CarloRenan/PCB_Avancado_iMX6_Rex/PCB_Avancado/Cotacao/README.md

# Orçamento de fabricação e montagem

Cotação da **JLCPCB** para o módulo iMX6 Rex e a Development Baseboard. Valores em **dólares americanos (USD)**.

## Fabricação das PCBs e montagem

| Item | Quantidade | Prazo de produção | Valor (USD) |
|---|---:|---|---:|
| PCB do módulo iMX6 Rex | 5 | 14–15 dias | US$ 510,03 |
| PCB da Development Baseboard | 5 | 8–9 dias | US$ 43,50 |
| Montagem da placa base nos dois lados | 2 | 5–6 dias | US$ 330,53 |
| **Subtotal, sem frete e tributos** | — | — | **US$ 884,06** |

Os prazos correspondem a cada serviço do orçamento.

## Especificações

| Parâmetro | Módulo | Placa base |
|---|---|---|
| Máscara de solda | Verde | Verde |
| Espessura | 1,6 mm | 1,6 mm |
| Acabamento superficial | ENIG | OSP |
| Quantidade de PCBs | 5 | 5 |
| Montagem PCBA | Indisponível para HDI nesta cotação | 2 unidades, nos dois lados |

O orçamento contempla cinco PCBs de cada modelo e a montagem de duas unidades da placa base. Para o módulo HDI, a JLCPCB informa indisponibilidade do serviço de montagem PCBA.

## Frete

| Serviço | Valor | Prazo estimado | Peso |
|---|---:|---|---|
| DHL Express — módulo | US$ 42,51 | 4–8 dias úteis | 0,15 kg |

O frete do módulo é apresentado separadamente. O subtotal de **US$ 884,06** considera os três itens de fabricação e montagem, sem incluir frete e tributos.

## Registro do orçamento

### Módulo iMX6 Rex

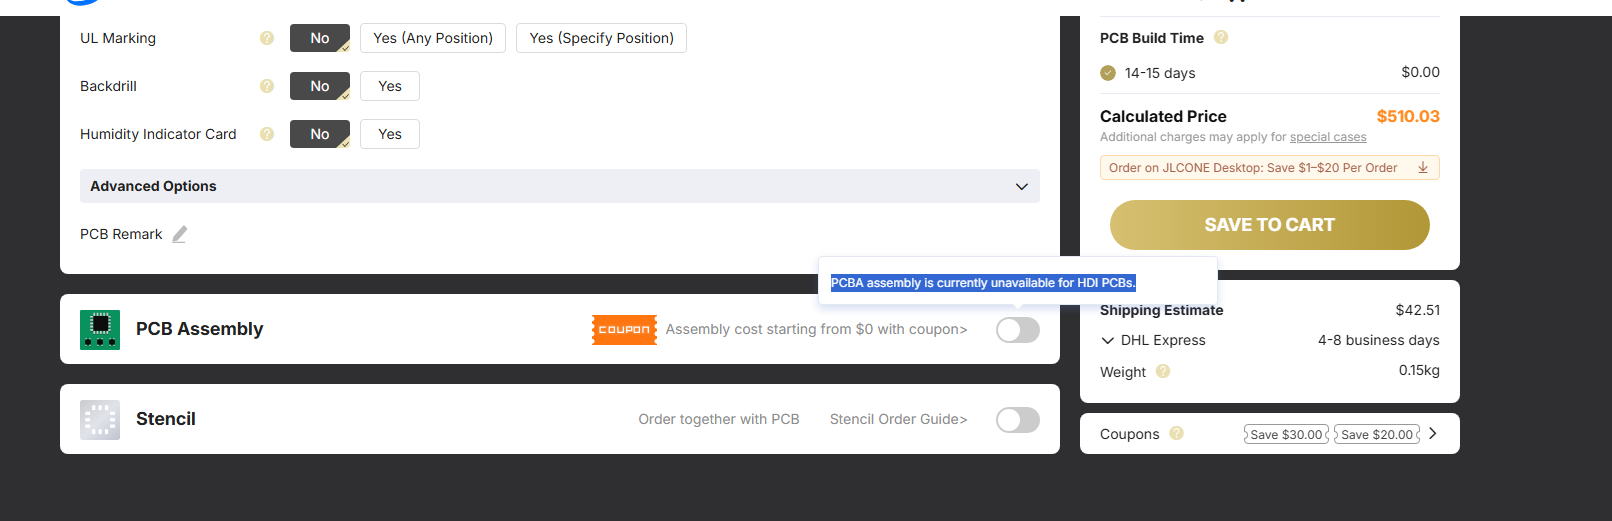
[picture p7: PCB_Avancado/Cotacao/01_Cotacao_modulo_HDI.png]
Cotação do módulo, frete e disponibilidade de montagem HDI


### PCBs e montagem da placa base

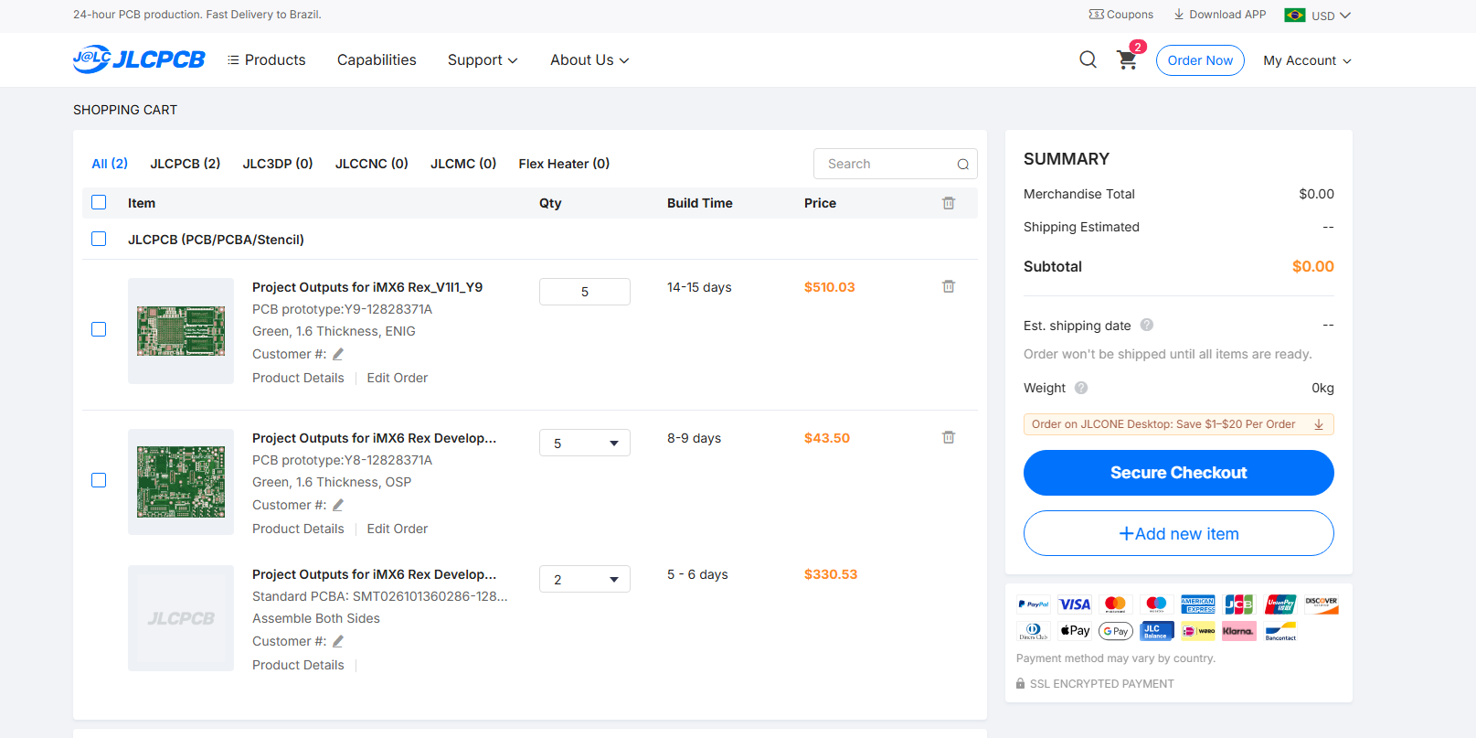
[picture p8: PCB_Avancado/Cotacao/02_Carrinho_PCB_e_montagem.png]
Orçamento das duas PCBs e da montagem da placa base
