CarloRenan/PCB_Avancado_iMX6_Rex/PCB_Avancado/Imagens/README.md

# Layout e vistas 3D

Vistas do módulo **iMX6 Rex — L7-02** e da **Development Baseboard — L7-01**.

## Conjunto

Vista mecânica do conjunto

*Montagem de referência com o modelo STEP M1 do módulo, incorporado ao projeto da placa base.*

## Módulo iMX6 Rex

**70 × 40 mm · 12 camadas de cobre**

| Face superior | Face inferior |
|---|---|
| Módulo — face superior | Módulo — face inferior |

O módulo concentra o processador i.MX6 Quad, a memória DDR3, a flash SPI e o PHY Ethernet. Os conectores J1/J2 fazem a interligação com a placa base.

## Development Baseboard

**135 × 110 mm · 6 camadas de cobre**

| Face superior, sem o módulo | Face inferior |
|---|---|
| Base — face superior | Base — face inferior |

A base distribui a alimentação e oferece os conectores de vídeo, rede, armazenamento, áudio e expansão.

## Layouts 2D

Comparação das quatro faces

| Placa | Face superior | Face inferior |
|---|---|---|
| Módulo | [Layout superior](Modulo_Superior.png) | [Layout inferior](Modulo_Inferior.png) |
| Base | [Layout superior](Placa_base_Superior.png) | [Layout inferior](Placa_base_Inferior.png) |

As vistas 2D apresentam trilhas externas, pads, vias e contornos. As faces inferiores são vistas por baixo. A comparação utiliza escalas diferentes para as duas placas.

## Representação do projeto

As vistas 3D utilizam os modelos STEP, os corpos extrudados e os posicionamentos definidos nos documentos Altium. As representações individuais correspondem à configuração base. Os cartões de expansão CR1/CR2 estão ocultos para facilitar a visualização dos conectores.

A espessura visual é de 1,6 mm. Cores, acabamento, cobre e serigrafia têm representação simplificada.

[Projetos Altium](../Projetos/) · [Funcionamento do circuito](../docs/FUNCIONAMENTO.md)
