CarloRenan/PCB_Avancado_iMX6_Rex/PCB_Avancado/Projetos/Modulo_L7-02/README.md

# Módulo iMX6 Rex

O módulo reúne o processador i.MX6 Quad, a memória DDR3, a flash SPI e os circuitos de alimentação e comunicação. A interligação com a Development Baseboard utiliza os conectores J1/J2.

| Característica | Especificação |
|---|---|
| Etapa do curso | L7-02 — Impedance Adjustment |
| Dimensões | 70 × 40 mm |
| Camadas de cobre | 12 |
| Projeto Altium | `iMX6 Rex_V1I1.PrjPcb` |
| Layout | `iMX6 Rex_V1I1_PCB.PcbDoc` |

Módulo iMX6 Rex em 3D

No Altium Designer, o arquivo `.PrjPcb` reúne os documentos do projeto. O `.PcbDoc` apresenta o posicionamento dos componentes, o roteamento e as camadas da placa.

[Funcionamento](../../docs/FUNCIONAMENTO.md) · [Galeria](../../Imagens/README.md) · [Lista de materiais](../../BoM/README.md)
