CarloRenan/PCB_Avancado_iMX6_Rex/PCB_Avancado/docs/ENTREGA.md

# Apresentação do trabalho

**Aluno:** Carlos Renan  
**Curso:** Advanced PCB Layout Course  
**Projeto:** iMX6 Rex e Development Baseboard  

## Objetivo

Apresentar o estudo de uma plataforma de computação embarcada e das técnicas de layout empregadas em placas multicamadas com interfaces de alta velocidade.

O trabalho relaciona os blocos funcionais dos esquemáticos ao posicionamento e ao roteamento das PCBs, com ênfase no ajuste de impedância do módulo e no ajuste dos pares diferenciais da placa base.

## Escopo

| Placa | Etapa | Características |
|---|---|---|
| Módulo iMX6 Rex | L7-02 — Impedance Adjustment | 70 × 40 mm; 12 camadas de cobre |
| Development Baseboard | L7-01 — Differential Pairs Fine Tuning | 135 × 110 mm; 6 camadas de cobre |

## Documentação do projeto

| Conteúdo | Localização |
|---|---|
| Projetos Altium, esquemáticos e layouts | [Projetos](../Projetos/) |
| Descrição dos componentes e interfaces | [Funcionamento do circuito](FUNCIONAMENTO.md) |
| Vistas 2D e 3D | [Galeria](../Imagens/README.md) |
| Lista de materiais em Excel e CSV | [BOM](../BoM/README.md) |
| Fabricação das PCBs e montagem na JLCPCB | [Orçamento](../Cotacao/README.md) |
| Projeto de referência e bibliografia | [Referências](ORIGEM.md) |

## Tópicos abordados

- Arquitetura do processador, memórias e interfaces.
- Posicionamento de componentes em placas multicamadas.
- Impedância das interligações e planos de referência.
- Roteamento e ajuste de pares diferenciais.
- Distribuição de alimentação e desacoplamento.
- Lista de materiais e orçamento de fabricação e montagem.
