CarloRenan/PCB_Avancado_iMX6_Rex/PCB_Avancado/docs/ORIGEM.md

# Projeto de referência e bibliografia

O estudo utiliza a plataforma **iMX6 Rex** e a **Development Baseboard**, apresentadas no **Advanced PCB Layout Course**, da **FEDEVEL Academy**.

## Etapas do projeto

| Placa | Etapa | Tema |
|---|---|---|
| Módulo iMX6 Rex | L7-02 | Impedance Adjustment |
| Development Baseboard | L7-01 | Differential Pairs Fine Tuning |

Os esquemáticos definem os componentes e as interligações elétricas. Os documentos PCB apresentam o posicionamento, o roteamento e a estrutura de camadas. As listas de materiais relacionam designadores, códigos de fabricante e footprints.

## Referências

- **iMX6 Rex.** Arquitetura e informações da plataforma. [Página do projeto](https://sites.google.com/imx6rex.com/www/home).
- **iMX6 Rex Development Baseboard.** Interfaces e características da placa base. [Documentação da placa](https://sites.google.com/imx6rex.com/www/application/imx6-development-board).
- **Altium Designer.** Variantes de projeto e configuração de montagem. [Documentação de variantes](https://www.altium.com/pt/documentation/altium-designer/design-variants).
- **FEDEVEL Academy.** Advanced PCB Layout Course: L7-02 — Impedance Adjustment e L7-01 — Differential Pairs Fine Tuning.

## Documentos técnicos

[Projetos Altium](../Projetos/) · [Lista de materiais](../BoM/README.md) · [Cotação JLCPCB](../Cotacao/README.md)
