CarloRenan/PCB_Avancado_iMX6_Rex/PCB_Avancado/Imagens/Modulo_Inferior.png

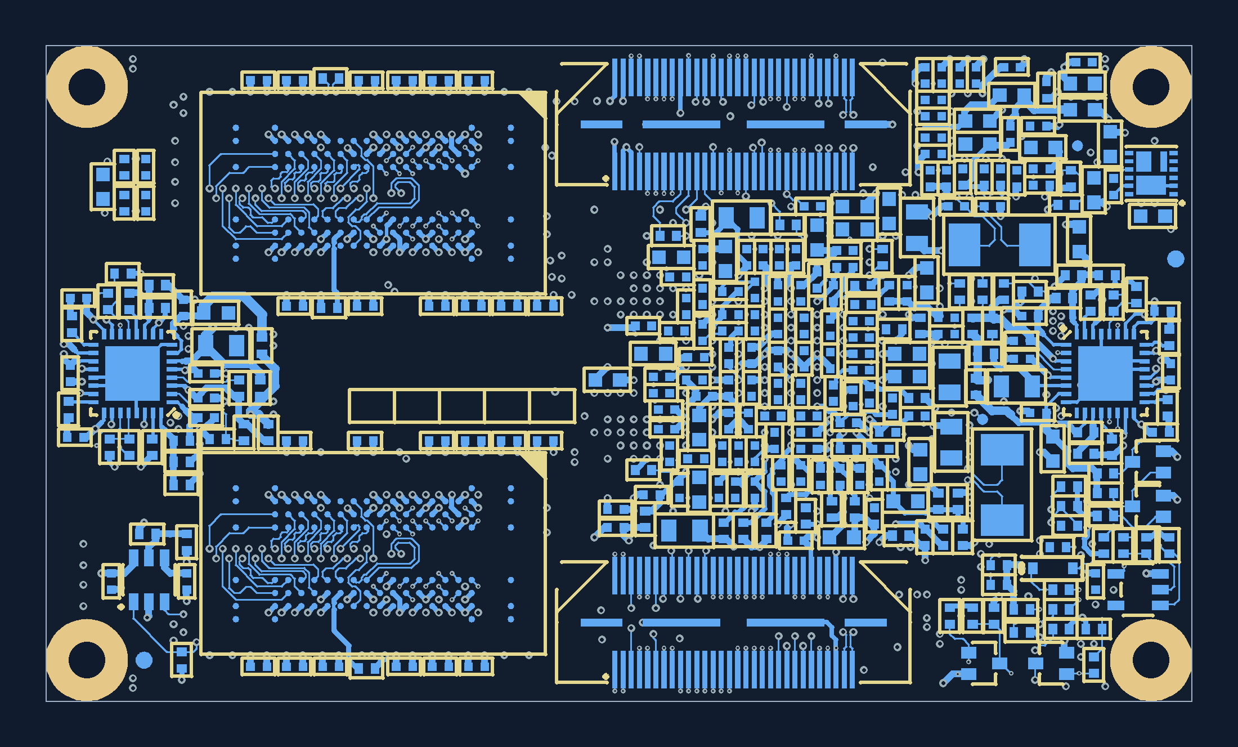
PCB_Avancado/Imagens/Modulo_Inferior.png
