CarloRenan/PCB_Avancado_iMX6_Rex/PCB_Avancado/Imagens/Placa_base_Inferior.png

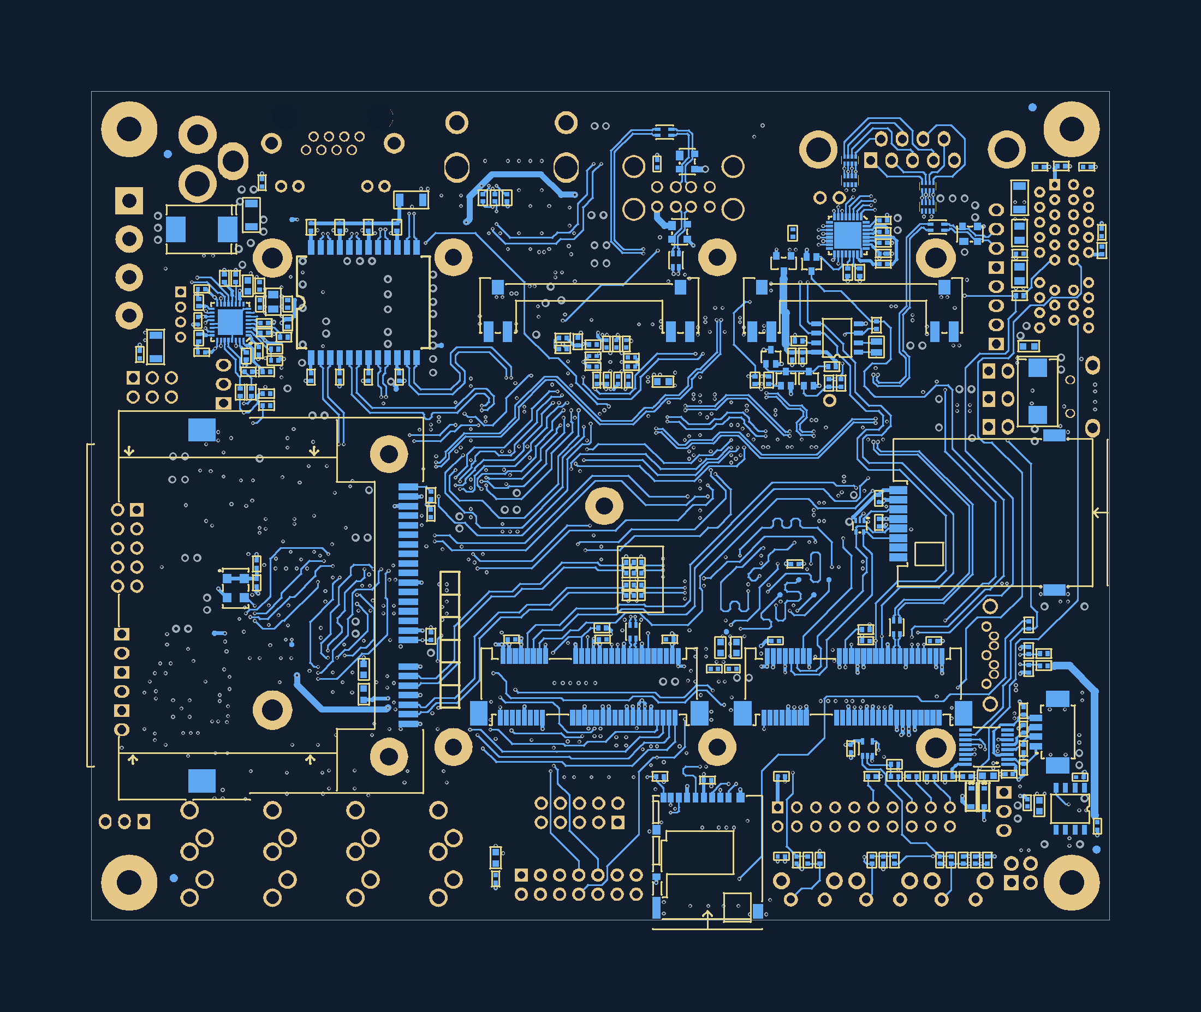
PCB_Avancado/Imagens/Placa_base_Inferior.png
