CarloRenan/PCB_Avancado_iMX6_Rex/PCB_Avancado/Imagens/Placa_base_Superior.png

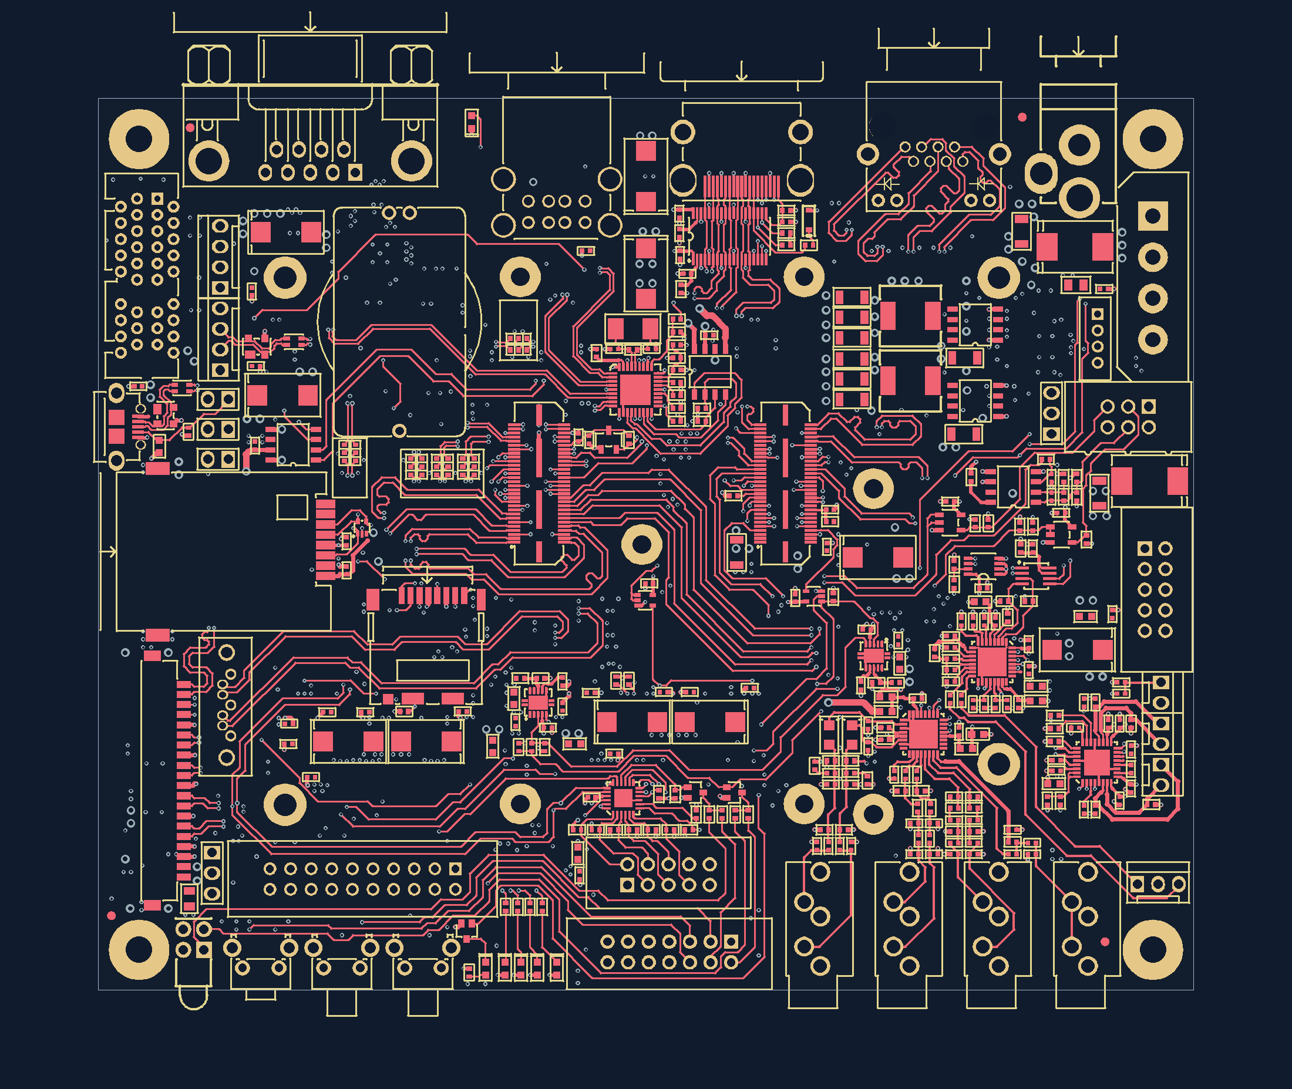
PCB_Avancado/Imagens/Placa_base_Superior.png
