CarloRenan/PCB_Avancado_iMX6_Rex/PCB_Avancado/BoM/BOM_e_Cotacao.xlsx

Sheet: Leia_me
PCB Avançado — Lista de materiais e cotação
Projeto | iMX6 Rex — módulo e Development Baseboard
Escopo da BOM | Projeto base, sem aplicação da variante Prototype; quantidades por uma placa.
Módulo | 457 componentes com MPN, agrupados em 66 linhas; 473 objetos no inventário PCB.
Placa base | 546 componentes com MPN, agrupados em 124 linhas; 580 objetos no inventário PCB.
Fonte | Esquemáticos e arquivos PCB das etapas L7-02 (módulo) e L7-01 (base).
Campos | MPN, fabricante, valor e descrição: esquemático; footprint: PCB.
Variante Prototype | 29 registros de configuração no módulo e 76 na placa base.
Itens auxiliares | Furos, fiduciais, pontos de teste, modelos e itens só do esquemático estão em aba separada.
Configuração | BOM da configuração base. A variante Prototype possui registros próprios nos arquivos CSV.
Cotação | Orçamento JLCPCB em dólares americanos (USD), com fabricação e montagem da placa base.
Arquivos de apoio | BOMs em CSV na pasta BoM e orçamento detalhado na pasta Cotacao.

Sheet: BOM_Modulo
BOM | Módulo
Projeto base • sem aplicar Prototype • quantidades por uma placa
Fonte: Modulo_L7-02 / arquivos SchDoc + PcbDoc
Designators | Qtd. / placa | Valor / comentário | Código do fabricante (MPN) | Fabricante | Footprint | Descrição
C1, C206, C207, C225, C226 | 5 | 1uF | C1005X5R1C105K | TDK Corporation | C0402 | CAP CER 1UF 16V 10% X5R 0402
C2, C209, C210, C220, C228, C229, C241 | 7 | 10uF | GRM31CR6YA106KA12L | Murata Electronics North America | C1206 | CAP CER 10UF 35V 10% X5R 1206
C3, C4, C5, C6, C8, C9, C10, C11, C21, C22, C23, C24, C25, C26, C27, C28, C29, C30, C31, C32, C33, C34, C35, C36, C37, C38, C39, C40, C41, C42, C43, C44, C45, C46, C47, C48, C49, C50, C51, C52, C53, C54, C55, C56, C57, C58, C59, C60, C61, C62, C64, C68, C73, C75, C76, C77, C79, C81, C82, C90, C91, C92, C93, C94, C95, C97, C98, C99, C100, C102, C103, C104, C105, C107, C108, C109, C110, C112, C113, C114, C115, C116, C117, C119, C120, C121, C122, C123, C124, C125, C126, C130, C131, C132, C133, C134, C136, C138, C140, C142, C143, C144, C145, C146, C149, C150, C152, C153, C154, C155, C157, C158, C159, C160, C161, C162, C163, C164, C165, C166, C167, C168, C169, C170, C171, C174 | 126 | 220nF | C1005X5R1E224M | TDK Corporation | C0402 | CAP CER 0.22UF 25V 20% X5R 0402
C7, C18, C20, C63, C65, C66, C67, C74, C87, C88, C89, C181, C187, C190, C192, C195, C203, C205, C211, C212, C219, C224, C230, C231, C238, C239, C240, C242 | 28 | 100nF | C1005X5R1H104K | TDK Corporation | C0402 | CAP CER 0.1UF 50V 10% X5R 0402
C12, C13, C14, C15, C16, C17, C96, C101, C106, C111, C118, C127, C128, C129, C135, C151, C172, C173 | 18 | 22u | GRM188R60G226MEA0L | Murata Electronics North America | C0603 | CAP CER 22UF 4V 20% X5R 0603
C19, C80, C177, C178, C180, C186, C191, C194, C199, C204, C221, C222, C223 | 13 | 10µF | C1608X5R0J106M | TDK Corporation | C0603 | CAP CER 10UF 6.3V 20% X5R 0603
C69, C70, C71, C72, C139 | 5 | 10nF | C1005X7R1H103K | TDK Corporation | C0402 | CAP CER 10000PF 50V 10% X7R 0402
C78, C243, C244, C245, C246, C247 | 6 | 4u7 | C1005X5R1A475M | TDK Corporation | C0402 | CAP CER 4.7UF 10V 20% X5R 0402
C83, C84, C85, C86 | 4 | 18pF | C1005C0G1H180J | TDK Corporation | C0402 | CAP CER 18PF 50V 5% NP0 0402
C137, C141, C147, C148, C156 | 5 | 22u | C2012X5R1C226K | TDK Corporation | C0805 | CAP CER 22UF 16V 10% X5R 0805
C175, C176 | 2 | 22pF | C1005C0G1H220J | TDK Corporation | C0402 | CAP CER 22PF 50V 5% NP0 0402
C179 | 1 | 560pF | GRM1555C1H561JA01D | Murata Electronics North America | C0402 | CAP CER 560PF 50V 5% NP0 0402
C182, C183, C184, C185, C188, C189, C193, C196, C197, C198, C200, C201, C202, C218, C237, C248, C249 | 17 | 10nF | C1005X7R1C103K | TDK Corporation | C0402 | CAP CER 10000PF 16V 10% X7R 0402
C208, C227 | 2 | 1uF | GRM21BR71H105KA12L | Murata Electronics North America | C0805 | CAP CER 1UF 50V 10% X7R 0805
C213, C214, C215, C216, C217, C232, C233, C234, C235, C236 | 10 | 100µF | C3216X5R1A107M | TDK Corporation | C1206 | CAP CER 100UF 10V 20% X5R 1206
D1 | 1 | RB751V-40-TP | RB751V-40-TP | Micro Commercial Co | SOD323 | DIODE SCHTKY 30MA 30V SOD-323
D2 | 1 | Green | LG L29K-G2J1-24-Z | OSRAM Opto Semiconductors Inc | LED_0603 | LED SMARTLED GREEN 570NM 0603
D3 | 1 | Orange | LO L29K-H2K1-24-Z | OSRAM Opto Semiconductors Inc | LED_0603 | LED SMARTLED ORANGE 606NM 0603
FB1, FB2, FB8 | 3 | 220R, 2.5A | BLM18SG221TN1D | Murata Electronics North America | C0603 | FERRITE CHIP 220 OHM 2500MA 0603
FB3, FB4, FB6, FB7 | 4 | BLM18KG101TN1D | BLM18KG101TN1D | Murata Electronics North America | C0603 | FERRITE CHIP 100 OHM BEAD 0603
FB5 | 1 | BLM15AX601SN1D | BLM15AX601SN1D | Murata Electronics North America | C0402 | FERRITE CHIP 600 OHM 0402
J1, J2 | 2 | QSH-030-01-L-D-A | QSH-030-01-L-D-A | Samtec Inc | QSH-030-01-L-D-A | CONN RCPT HI-SPD .5MM 60POS DL
L1 | 1 | 4µ7 | IHLP2525CZER4R7M01 | Vishay/Dale | IHLP_255MILX270MIL | INDUCTOR POWER 4.7UH 5.5A SMD
L2, L4, L5 | 3 | 3u3 | IHLP2525CZER3R3M01 | Vishay Dale | IHLP_255MILX270MIL | INDUCTOR POWER 3.3UH 6A SMD
L3 | 1 | VLCF4020T-100MR85 | VLCF4020T-100MR85 | TDK Corporation | VLCF4020 | INDUCTOR POWER 10UH .85A SMD
Q1, Q2, Q5, Q8, Q9 | 5 | 2N7002BKW,115 | 2N7002BKW,115 | NXP Semiconductors | SC70_SOT323 | MOSFET N-CH 60V 310MA SOT323
Q3, Q4, Q6, Q7 | 4 | SI4816BDY-T1-GE3 | SI4816BDY-T1-GE3 | Vishay/Siliconix | 8_SOIC_3.9MM | MOSFET DL N-CH 30V 6.8A 8-SOIC
R1, R35, R36, R50, R52, R66, R72, R83, R85, R86, R90, R92, R112, R159, R160, R161 | 16 | 22R | RC0402FR-0722RL | Yageo | R0402 | RES 22.0 OHM 1/16W 1% 0402 SMD
R2, R3, R15 | 3 | 200R | CRCW0402200RFKED | Vishay Dale | R0402 | RES 200 OHM 1/16W 1% 0402 SMD
R4, R5, R8, R9, R10, R11, R12 | 7 | 240R | RMCF0402FT240R | Stackpole Electronics Inc | R0402 | RES TF 240 OHM 1% 0.0625W 0402
R6, R7, R33, R38, R39, R40, R41, R42, R43, R48, R49, R57, R58, R60, R62, R63, R64, R67, R68, R69, R75, R91, R94, R95, R96, R97, R98, R100, R103, R104, R109, R110, R115, R127, R129, R130, R131, R132, R133, R136, R151, R153, R154, R155, R158, R165 | 46 | 10k | RC0402FR-0710KL | Yageo | R0402 | RES 10.0K OHM 1/16W 1% 0402 SMD
R13, R14, R18, R19, R23, R24, R25, R26, R27, R34, R51, R65, R70, R71, R74, R76, R78, R80, R88, R93, R105, R106, R107, R108, R116, R117, R128, R140, R141, R152, R156, R157, R163, R164 | 34 | 0R | RC0402JR-070RL | Yageo | R0402 | RES 0.0 OHM 1/16W 0402 SMD
R16, R17 | 2 | 49.9R | RC0402FR-0749R9L | Yageo | R0402 | RES 49.9 OHM 1/16W 1% 0402 SMD
R20 | 1 | 191R | CRCW0402191RFKED | Vishay Dale | R0402 | RES 191 OHM 1/16W 1% 0402 SMD
R21, R22 | 2 | 47k | RC0402FR-0747KL | Yageo | R0402 | RES 47.0K OHM 1/16W 1% 0402 SMD
R28, R29, R31, R32, R44, R45, R46, R47, R55, R56, R59, R84, R87, R89, R120 | 15 | 4k99 | RMCF0402FT4K99 | Stackpole Electronics Inc | R0402 | RES TF 4.99K OHM 1% 1/16W 0402
R30 | 1 | 1k6 | ERJ-2RKF1601X | Panasonic Electronic Components | R0402 | RES 1.6K OHM 1/10W 1% 0402 SMD
R37 | 1 | 2M2 | CRCW04022M20FKED | Vishay Dale | R0402 | RES 2.20M OHM 1/16W 1% 0402 SMD
R53, R54 | 2 | 10M | CRCW040210M0FKED | Vishay Dale | R0402 | RES 10.0M OHM 1/16W 1% 0402 SMD
R61, R99, R101, R102, R162 | 5 | 1k | RC0402FR-071KL | Yageo | R0402 | RES 1.00K OHM 1/16W 1% 0402 SMD
R73, R111, R137, R143, R144 | 5 | 100k | RMCF0402FT100K | Stackpole Electronics Inc | R0402 | RES 100K OHM 1/16W 1% 0402 SMD
R77 | 1 | 2R2 | CRCW04022R20FKED | Vishay Dale | R0402 | RES 2.20 OHM 1/16W 1% 0402 SMD
R79, R118, R142 | 3 | 10R | RC0402FR-0710RL | Yageo | R0402 | RES 10.0 OHM 1/16W 1% 0402 SMD
R81, R82, R113, R114 | 4 | 220R | RC0402FR-07220RL | Yageo | R0402 | RES 220 OHM 1/16W 1% 0402 SMD
R119 | 1 | 14K | RC0402FR-0714KL | Yageo | R0402 | RES 14.0K OHM 1/16W 1% 0402 SMD
R121, R122, R145, R146 | 4 | 1R | RC0402FR-071RL | Yageo | R0402 | RES 1.00 OHM 1/16W 1% 0402 SMD
R123 | 1 | 39k | RC0402FR-0739KL | Yageo | R0402 | RES 39.0K OHM 1/16W 1% 0402 SMD
R124, R125, R148, R149 | 4 | 200k | RC0402FR-07200KL | Yageo | R0402 | RES 200K OHM 1/16W 1% 0402 SMD
R126, R150 | 2 | 10k5 | CRCW040210K5FKED | Vishay/Dale | R0402 | RES 10.5K OHM 1/16W 1% 0402 SMD
R134 | 1 | 12k | RC0402FR-0712KL | Yageo | R0402 | RES 12.0K OHM 1/16W 1% 0402 SMD
R135 | 1 | 3k3 | RC0402FR-073K3L | Yageo | R0402 | RES 3.30K OHM 1/16W 1% 0402 SMD
R138 | 1 | 330k | CRCW0402330KFKED | Vishay Dale | R0402 | RES 330K OHM 1/16W 1% 0402 SMD
R139 | 1 | 120k | RC0402FR-07120KL | Yageo | R0402 | RES 120K OHM 1/16W 1% 0402 SMD
R147 | 1 | 27k | RC0402FR-0727KL | Yageo | R0402 | RES 27.0K OHM 1/16W 1% 0402 SMD
U1 | 1 | MCIMX6Q5EYM10AC | MCIMX6Q5EYM10AC | Freescale Semiconductor | PBGA624 | IC MCU 32BIT ARM QUAD 624FCBGA
U2, U3, U4, U5 | 4 | MT41J128M16HA-15E:D TR | MT41J128M16HA-15E:D TR | Micron Technology Inc | 96_FPGA_DD3 | IC DDR3 SDRAM 2GBIT 667MHZ 96BGA
U6 | 1 | TPS3808G09DBVR | TPS3808G09DBVR | Texas Instruments | DBV_SOT_23_6 | IC VOLT SUPERVISOR 0.9V SOT23-6
U7 | 1 | SN74AHC1G09DBVR | SN74AHC1G09DBVR | Texas Instruments | DBV_SOT_23_5 | IC GATE AND SGL 2INP SOT23-5
U8 | 1 | KSZ9021RN | KSZ9021RN | Micrel Inc | QFN48_7MMX7MM | IC TXRX 10/100/1000 SGL 48QFN
U9 | 1 | MIC33050-4YHL TR | MIC33050-4YHL TR | Micrel Inc | MLF_3X3_12PINS | IC BUCK SYNC 1.2V 0.6A 12MLF
U10 | 1 | SST25VF016B-75-4I-QAF-ND | SST25VF016B-75-4I-QAF | Microchip Technology | WSON8_6X5MM | IC FLASH 16MBIT 75MHZ 8WSON
U11, U13 | 2 | ISL6236AIRZ | ISL6236AIRZ | Intersil | 32_VFQFN_EXPOSED_PAD | IC MAIN PWR CTRLR QUAD 32-QFN
U12 | 1 | TPS62175DQCT | TPS62175DQCT | Texas Instruments | DQC_PWSON-N10 | IC REG BUCK SYNC ADJ 0.5A 10WSON
Y1 | 1 | 24MHz | ABM7-24.000MHZ-D-2-Y-T | Abracon Corporation | ABM7_V1_1 | CRYSTAL 24.0000MHZ 18PF SMD
Y2 | 1 | 32.768kHz | ABS06-32.768KHZ-9-1-T | Abracon Corporation | ABS06 | CRYSTAL 32.768 KHZ 9.0 PF SMD
Y3 | 1 | 25MHz | ABM7-25.000MHZ-D-2-Y-T | Abracon Corporation | ABM7_V1_1 | CRYSTAL 25.0000 MHZ 18PF SMD
Total de componentes com MPN | 457

Sheet: BOM_Base
BOM | Placa base
Projeto base • sem aplicar Prototype • quantidades por uma placa
Fonte: Placa_base_L7-01 / arquivos SchDoc + PcbDoc
Designators | Qtd. / placa | Valor / comentário | Código do fabricante (MPN) | Fabricante | Footprint | Descrição
C1, C3, C6, C8, C9, C10, C14, C17, C22, C23, C27, C28, C29, C30, C31, C57, C69, C71, C72, C73, C74, C75, C77, C78, C80, C83, C84, C86, C88, C89, C90, C93, C94, C97, C98, C101, C103, C106, C108, C109, C110, C111, C112, C114, C115, C116, C117, C118, C120, C121, C127, C128, C129, C140, C148, C151, C152, C153, C154, C155, C156, C157, C158, C163, C166, C167, C170, C171, C173, C175, C176, C178, C180, C186, C187, C195, C198, C199, C200, C201, C202, C203, C204, C205, C206, C207, C213, C214, C216, C218 | 90 | 100nF | C1005X5R1H104K | TDK Corporation | C0402 | CAP CER 0.1UF 50V 10% X5R 0402
C2, C7, C82, C184, C185, C196, C197, C208 | 8 | 10uF | GRM31CR6YA106KA12L | Murata Electronics North America | C1206 | CAP CER 10UF 35V 10% X5R 1206
C4, C18, C33, C37, C38, C39, C41, C42, C44, C45, C46, C48, C50, C51, C53, C58, C59, C60, C61, C63, C64, C65, C66, C68, C81, C95, C105, C107, C113, C130, C131, C136, C138, C147, C159, C161, C162, C168, C169, C181, C182, C209, C211 | 43 | 1uF | C1005X5R1C105K | TDK Corporation | C0402 | CAP CER 1UF 16V 10% X5R 0402
C5, C11, C79, C177 | 4 | 22u | C2012X5R1C226K | TDK Corporation | C0805 | CAP CER 22UF 16V 10% X5R 0805
C12, C13, C24, C25, C70 | 5 | 330u | T520D337M006ATE045 | Kemet | C2917 | CAP TANT 330UF 6.3V 20% 2917
C15, C16, C19, C26, C32, C34, C102, C104, C141, C142, C210, C212, C215, C217 | 14 | 4u7 | C1005X5R1A475M | TDK Corporation | C0402 | CAP CER 4.7UF 10V 20% X5R 0402
C20, C35, C43, C76, C126, C150, C172, C174, C179 | 9 | 10µF | C1608X5R0J106M | TDK Corporation | C0603 | CAP CER 10UF 6.3V 20% X5R 0603
C21, C36, C132, C133, C143, C144 | 6 | 2700pF | GRM155R71H272KA01D | Murata Electronics North America | C0402 | CAP CER 2700PF 50V 10% X7R 0402
C40, C85, C87, C91, C92, C96 | 6 | 330u | T495D337K010ATE150 | Kemet | C2917 | CAP TANT 330UF 10V 10% 2917
C47, C52, C55, C56, C67 | 5 | 470nF | C1005X5R1C474K | TDK Corporation | C0402 | CAP CER 0.47UF 16V 10% X5R 0402
C49 | 1 | 10nF | C1005X7R1H103K | TDK Corporation | C0402 | CAP CER 10000PF 50V 10% X7R 0402
C54, C122, C123, C134, C135, C145, C146, C149 | 8 | 270pF | GRM155R71H271KA01D | Murata Electronics North America | C0402 | CAP CER 270PF 50V 10% X7R 0402
C62 | 1 | 2u2 | C1005X5R1A225K | TDK Corporation | C0402 | CAP CER 2.2UF 10V 10% X5R 0402
C99, C100 | 2 | 18pF | C1005C0G1H180J | TDK Corporation | C0402 | CAP CER 18PF 50V 5% NP0 0402
C119 | 1 | 1000pF, 2kV | C1206X102KGRACTU | Kemet | C1206 | CAP CER 1000PF 2KV 10% X7R 1206
C124, C125 | 2 | 100pF | C1005C0G1H101J | TDK Corporation | C0402 | CAP CER 100PF 50V 5% NP0 0402
C137, C139 | 2 | 220u, 4V | TLNS227M004R3000 | AVX Corporation | C1206 - TLN S Case Tantal | CAP TANT 220UF 4V 20% 1206
C160 | 1 | 220nF | C1005X5R1E224M | TDK Corporation | C0402 | CAP CER 0.22UF 25V 20% X5R 0402
C164, C165 | 2 | 4x 220pF | CKCL44X7R1H221M | TDK Corporation | 4X_CAP_CC0805_CKCL44 | CAP ARRAY 4CH 220PF 50V 0805
C183 | 1 | 1uF | GRM21BR71H105KA12L | Murata Electronics North America | C0805 | CAP CER 1UF 50V 10% X7R 0805
C188, C189, C190, C191, C192, C193 | 6 | 100µF | C3216X5R1A107M | TDK Corporation | C1206 | CAP CER 100UF 10V 20% X5R 1206
C194 | 1 | 10nF | C1005X7R1C103K | TDK Corporation | C0402 | CAP CER 10000PF 16V 10% X7R 0402
CFAST1 | 1 | 7E50-C016-00 | 7E50-C016-00 | 3M | CFAST_LOCKER | CF CARD EJECT/LATCHING RETAINER
D1, D2, D3, D6 | 4 | Green | LG L29K-G2J1-24-Z | OSRAM Opto Semiconductors Inc | LED_0603 | LED SMARTLED GREEN 570NM 0603
D4, D5 | 2 | BZA956A,115 | BZA956A,115 | NXP Semiconductors | SOT665 | TVS ZENER QUAD 5.6V SOT665
D7, D21, D22 | 3 | BAT54HT1G | BAT54HT1G | Fairchild Semiconductor | SOD323 | DIODE SCHOTTKY 30V 0.2A SOD323
D8, D9, D10, D11, D13 | 5 | BGX50AE6327 | BGX50AE6327 | Infineon Technologies | SOT143 | DIODE SWITCHING 50V SOT-143
D12, D14 | 2 | Red | LS L29K-H1J2-1-Z | OSRAM Opto Semiconductors Inc | LED_0603 | LED SMARTLED RED 630NM 0603 SMD
D15 | 1 | BAT54C-7-F | BAT54C-7-F | Diodes Inc | SOT-23-3-123 | DIODE SCHOTTKY DUAL 30V SOT23-3
D16, D17, D20 | 3 | B560C-13-F | B560C-13-F | Diodes Inc | SMC | DIODE SCHOTTKY 60V 5A SMC
D18 | 1 | 553-0121F | 553-0121F | Dialight | 553-0121F | LED 2HI 3MM GREEN OVER RED PCMNT
D19 | 1 | PGB1010603MR | PGB1010603MR | Littelfuse Inc | C0603 | SUPPRESSOR ESD 24VDC 0603 SMD
FB1, FB2, FB3, FB4, FB22 | 5 | 220R, 2.5A | BLM18SG221TN1D | Murata Electronics North America | C0603 | FERRITE CHIP 220 OHM 2500MA 0603
FB5, FB8, FB9, FB14, FB15, FB16, FB17, FB18, FB24 | 9 | BLM15AX601SN1D | BLM15AX601SN1D | Murata Electronics North America | C0402 | FERRITE CHIP 600 OHM 0402
FB6, FB7, FB10, FB11, FB12, FB13, FB19, FB23, FB25, FB26 | 10 | MPZ1608S601A 600OHM/1A | MPZ1608S601A | TDK Corporation | C0603 | FERRITE CHIP BEAD 600 OHM SMD
FB20, FB21 | 2 | 4x 220R | BLA2ABB221SN4D | Murata Electronics North America | 4X0402_BLA2A_MURATA | FERRITE ARRAY 220 OHM 0804 SMD
J1, J2 | 2 | QTH-030-01-L-D-A | QTH-030-01-L-D-A | Samtec Inc | QTH-030-01-L-D-A | CONN HEADER HS .5MM 60POS DL AU
J3 | 1 | 10018783-10010TLF | 10018783-10010TLF | FCI | MINI_PCIE_36PIN | CONN PCI EXPRESS 36POS VERT PCB
J4, J9 | 2 | MM60-52B1-E1-R650 | MM60-52B1-E1-R650 | JAE Electronics | MINI_PCIE_52PIN_CARD_CON | CONN MINI EXPRESS CARD 52POS SMD
J5, J7 | 2 | 0475531001 | 0475531001 | Molex Inc | SIM_CARD_PUSH | CONN CARD HOLDER SIM 6POS SMD
J6, J8 | 2 | MM60-EZH059-B5-R650 | MM60-EZH059-B5-R650 | JAE Electronics | MINI_PCIE_52PIN_CARD_LATCH | CONN MINI EXPRESS CARD LATCH SMD
J10, J11, J12 | 3 | 76384-302LF | 76384-302LF | FCI | HDR_1X2_2.54MM_SHDR | CONN HEADER 2POS .100" STR GOLD
J13 | 1 | 76384-303LF | 76384-303LF | FCI | HDR_1X3_2.54MM_SHDR_V2 | CONN HEADER 3POS .100" STR GOLD
J14 | 1 | 0471554001 | 0471554001 | Molex Inc | SATA_VERTICAL | CONN SATA HDR 7POS PCB VERT
J15 | 1 | N7G24-A0B2RB-10-0HT | N7G24-A0B2RB-10-0HT | 3M | CFAST10 | CFAST HEADER STANDOFF SMD R/A
J16 | 1 | 47151-0001 | 47151-0001 | Molex Connector Corporation | HDMI | CONN RCPT 19POS HDMI RT ANG SMD
J17, J18 | 2 | HDR 1x3 | 68000-103HLF | FCI | HDR_1X3_2.54MM | BERGSTIK II .100" SR STRAIGHT
J19 | 1 | HDR 2X3, BOXED | 30306-6002HB | 3M | HDR_2X3_2.54MM_BOXED | CONN HEADER 6POS DL STR GOLD
J20, J23 | 2 | 76384-304LF | 76384-304LF | FCI | HDR_1X4_2.54MM_SHDR | CONN HEADER 4POS .100" STR GOLD
J21 | 1 | USB MICRO AB | 0475890001 | Molex Inc | USB_MICRO_AB | CONN RCPT MICRO USB AB R/A SMD
J22 | 1 | 5787617-1 | 5787617-1 | TE Connectivity | USB-2A | CONN RCPT R/A 4OVER4POS GOLD PCB
J24 | 1 | 2-406549-1 | 2-406549-1 | Tyco | RJ45LED | CONN MOD JACK 8POS R/A Y-G PCB
J25 | 1 | SJ1-3535NG | SJ1-3535NG | CUI Inc | SJ1-3535NG | CONN JACK STEREO R/A 5PIN 3.5MM
J26 | 1 | SJ1-3535NG-BE | SJ1-3535NG-BE | CUI Inc | SJ1-3535NG | CONN JACK STEREO 5POS 3.5MM PCB
J27 | 1 | SJ1-3535NG-GR | SJ1-3535NG-GR | CUI Inc | SJ1-3535NG | CONN JACK STEREO 5POS 3.5MM PCB
J28 | 1 | SJ1-3535NG-PI | SJ1-3535NG-PI | CUI Inc | SJ1-3535NG | CONN JACK STEREO 5POS 3.5MM PCB
J29 | 1 | DM3AT-SF-PEJM5 | DM3AT-SF-PEJM5 | Hirose Electric Co Ltd | USD_DM3AT | CONN MICRO SD R/A PUSH-PUSH SMD
J30 | 1 | 1734351-1 | 1734351-1 | TE Connectivity | DBA9_M_RA | CONN D-SUB PLUG R/A 9POS GOLD/FL
J31, J34 | 2 | HDR 2x5, BOXED | D2510-6002-AR | 3M | HDR_2X5_2.54MM_BOXED | CONN HEADER 10POS VERT 10GOLD
J32 | 1 | BA2032 | BA2032 | MPD (Memory Protection Devices) | BA2032 | HOLDER COIN CELL CR2032 EJECT
J33 | 1 | HDR 2x7, BOXED | D2514-6002-AR | 3M | HDR_2X7_2.54MM_BOXED | CONN HEADER 14POS VERT 10GOLD
J35 | 1 | Hdr 4x2mm BOXED | 0532530470 | Molex Inc | HDR_1X4_2MM_SHDR | CONN HEADER 4POS 2MM VERT TIN
J36 | 1 | 5103308-5 | 5103308-5 | TE Connectivity | HDR_2x10_2.54mm_BOXED | CONN HEADER LOPRO STR 20POS GOLD
J37 | 1 | PJ-002AH | PJ-002AH | CUI Inc | POWER_JACK_5.5_2.1MM_NS | CONN PWR JACK 2.1X5.5MM HIGH CUR
J38 | 1 | 0015244449 | 0015244449 | Molex Inc | 015244449 | CONN HEADER 4POS .200 VERT
J39 | 1 | DM3C-SF | DM3C-SF | Hirose Electric Co Ltd | USD_DM3CS | CONN MICRO SD R/A HING TYPE SMD
J40 | 1 | 0532610471 | 0532610471 | Molex Inc | 0532610471 | CONN HEADER 4POS 1.25MM R/A SMD
J41 | 1 | FI-SE20P-HFE | FI-SE20P-HFE | JAE Electronics | FI-SE20P-HFE | CONN RCPT 1.25MM 20POS SMD R/A
JP1, JP2, JP3 | 3 | HDR 1x2 | 68001-202HLF | FCI | HDR_1X2_2.54MM | BERGSTIK II .100" SR STRAIGHT
L1, L2, L3, L4, L5, L6, L7 | 7 | ACM2012-900-2P-T002 | ACM2012-900-2P-T002 | TDK Corporation | ACM2012 | CHOKE COMM MODE 90 OHM .4A SMD
L8, L9 | 2 | 4µ7 | IHLP2525CZER4R7M01 | Vishay/Dale | IHLP_255MILX270MIL | INDUCTOR POWER 4.7UH 5.5A SMD
Q1, Q4, Q5, Q6, Q7, Q8, Q9 | 7 | 2N7002BKW,115 | 2N7002BKW,115 | NXP Semiconductors | SC70_SOT323 | MOSFET N-CH 60V 310MA SOT323
Q2, Q3 | 2 | SI4816BDY-T1-GE3 | SI4816BDY-T1-GE3 | Vishay/Siliconix | 8_SOIC_3.9MM | MOSFET DL N-CH 30V 6.8A 8-SOIC
R1, R2, R3, R4, R5, R6, R7, R8, R9, R10, R11, R12, R13, R14, R16, R24, R32, R34, R36, R37, R38, R39, R40, R41, R42, R43, R46, R56, R62, R63, R64, R65, R66, R67, R68, R69, R88, R89, R104, R105, R106, R112, R113, R120, R123, R124, R128, R129, R130, R133, R137, R138, R143, R153, R155, R156, R159, R162, R163, R164, R169, R170, R173, R174, R184 | 65 | 0R | RC0402JR-070RL | Yageo | R0402 | RES 0.0 OHM 1/16W 0402 SMD
R15, R31, R33, R35, R51, R52, R53, R54, R55, R70, R71, R72, R73, R108, R109, R111, R114, R115, R116, R117, R118, R121, R122, R134, R135, R136, R139, R140, R147, R150, R151, R152, R154, R157, R158, R165, R166, R167, R168, R172, R183, R187 | 42 | 10k | RC0402FR-0710KL | Yageo | R0402 | RES 10.0K OHM 1/16W 1% 0402 SMD
R17, R131, R132, R175, R176, R177, R178, R179, R180, R181, R182 | 11 | 200k | RC0402FR-07200KL | Yageo | R0402 | RES 200K OHM 1/16W 1% 0402 SMD
R18 | 1 | 2k1 | CRCW04022K10FKED | Vishay Dale | R0402 | RES 2.10K OHM 1/16W 1% 0402 SMD
R19, R21, R22, R25, R107 | 5 | 330R | CRCW0402330RFKED | Vishay Dale | R0402 | RES 330 OHM 1/16W 1% 0402 SMD
R20, R27 | 2 | 2k4 | CRCW04022K40FKED | Vishay Dale | R0402 | RES 2.40K OHM 1/16W 1% 0402 SMD
R23 | 1 | 1M | RC0402FR-071ML | Yageo | R0402 | RES 1.00M OHM 1/16W 1% 0402 SMD
R26 | 1 | 3k | RC0402FR-073KL | Yageo | R0402 | RES 3K OHM 1/16W 1% 0402 SMD
R28, R29, R30, R102 | 4 | 2k2 | RC0402FR-072K2L | Yageo | R0402 | RES 2.20K OHM 1/16W 1% 0402 SMD
R44, R74, R75, R76, R77, R79, R80, R82, R83, R96, R97, R171, R185, R186 | 14 | 100k | RMCF0402FT100K | Stackpole Electronics Inc | R0402 | RES 100K OHM 1/16W 1% 0402 SMD
R45, R59, R78, R110 | 4 | 1k | RC0402FR-071KL | Yageo | R0402 | RES 1.00K OHM 1/16W 1% 0402 SMD
R47, R90, R91 | 3 | 15k | RC0402FR-0715KL | Yageo | R0402 | RES 15.0K OHM 1/16W 1% 0402 SMD
R48, R49, R57, R160, R161 | 5 | 4k99 | RMCF0402FT4K99 | Stackpole Electronics Inc | R0402 | RES TF 4.99K OHM 1% 1/16W 0402
R50 | 1 | 27k | RC0402FR-0727KL | Yageo | R0402 | RES 27.0K OHM 1/16W 1% 0402 SMD
R58 | 1 | 365R | RMCF0402FT365R | Stackpole Electronics Inc | R0402 | RES TF 365 OHM 1% 1/16W 0402
R60 | 1 | 1k8 | CRCW04021K80FKED | Vishay Dale | R0402 | RES 1.80K OHM 1/16W 1% 0402 SMD
R61 | 1 | 3k3 | RC0402FR-073K3L | Yageo | R0402 | RES 3.30K OHM 1/16W 1% 0402 SMD
R81 | 1 | 12k | RC0402FR-0712KL | Yageo | R0402 | RES 12.0K OHM 1/16W 1% 0402 SMD
R84, R85, R86, R87 | 4 | 75R | RC0402FR-0775RL | Yageo | R0402 | RES 75.0 OHM 1/16W 1% 0402 SMD
R92, R93, R141, R142, R149 | 5 | 33R | RMCF0402FT33R0 | Stackpole Electronics Inc | R0402 | RES TF 33 OHM 1% 1/16W 0402
R94, R95, R119 | 3 | 100R | RC0402FR-07100RL | Yageo | R0402 | RES 100 OHM 1/16W 1% 0402 SMD
R98, R99 | 2 | 562 | CRCW0402562RFKED | Vishay Dale | R0402 | RES 562 OHM 1/16W 1% 0402 SMD
R100, R101 | 2 | 47k5 | RC0402FR-0747K5L | Yageo | R0402 | RES 47.5K OHM 1/16W 1% 0402 SMD
R125 | 1 | 10R | RC0402FR-0710RL | Yageo | R0402 | RES 10.0 OHM 1/16W 1% 0402 SMD
R126, R127 | 2 | 1R | RC0402FR-071RL | Yageo | R0402 | RES 1.00 OHM 1/16W 1% 0402 SMD
R144, R145, R146, R148 | 4 | 240R | RMCF0402FT240R | Stackpole Electronics Inc | R0402 | RES TF 240 OHM 1% 0.0625W 0402
SW1 | 1 | FSMRA2JH | FSMRA2JH | TE Connectivity | FSMRA2JH | SWITCH TACTILE SPST-NO 0.05A 12V
SW2, SW3 | 2 | FSMRA3JH | FSMRA3JH | TE Connectivity | FSMRA3JH | SWITCH TACTILE SPST-NO 0.05A 12V
T1 | 1 | H5007NL | H5007NL | PULSE ELECTRONICS CORPORATION | H5007NL | MODULE SINGLE GIGABIT LAN 24SOIC
U1, U3 | 2 | TPS74801DRCR | TPS74801DRCR | Texas Instruments | DRC (S-PVSON-N10) | IC REG LDO ADJ 1.5A 10SON
U2 | 1 | TSC2007IPWR | TSC2007IPWR | Texas Instruments | PW (R-PDGO-G16) | IC TOUCH SCREEN 12BIT 16TSSOP
U4 | 1 | TPA6041A4RHBR | TPA6041A4RHBR | Texas Instruments | VQFN32 5X5X0.85 | IC AMP AUDIO PWR 2.6W AB 32VQFN
U5 | 1 | MAX9867ETJ+ | MAX9867ETJ+ | Maxim Integrated | QFN32 5X5X0.85 | IC STEREO AUD CODEC LP 32TQFN-EP
U6 | 1 | PCA9306DCTR | PCA9306DCTR | Texas Instruments | DCT_8 | IC VOLT-LEVEL TRANSLATOR SM8
U7 | 1 | CM2020-00TR | CM2020-00TR | ON Semiconductor | TSSOP_38 | IC HDMI TX PORT P/I 38-TSSOP
U8, U23 | 2 | SN74AHC1G09DBVR | SN74AHC1G09DBVR | Texas Instruments | DBV_SOT_23_5 | IC GATE AND SGL 2INP SOT23-5
U9 | 1 | TPS2034D | TPS2034D | Texas Instruments | 8_SOIC_3.9MM | IC 3.0A POWER DIST SWITCH 8-SOIC
U10 | 1 | LM358AMX | LM358AMX | Fairchild Semiconductor | 8_SOIC_3.9MM | IC OPAMP DUAL 0-70DEG C 8-SOIC
U11, U12 | 2 | MIC2026-1YM TR | MIC2026-1YM TR | Micrel Inc | 8_SOIC_3.9MM | IC SW DISTRIBUTION 2CHAN 8SOIC
U13 | 1 | USB2514BI-AEZG | USB2514BI-AEZG | Microchip Technology | QFN36_6MMX6MM | USB HUB CONT IND TEMP 36QFNE3
U14 | 1 | SGTL5000XNAA3R2 | SGTL5000XNAA3R2 | Freescale Semiconductor | QFN32 5X5X0.85 | IC AUDIO CODEC STEREO 32-QFN
U15 | 1 | TLV803SDBZR | TLV803SDBZR | Texas Instruments | DBZ | IC VOLT SUPERVISR 2.93V SOT23-3
U16 | 1 | ISL4245EIRZ | ISL4245EIRZ | Intersil | QFN32 5X5X0.85 | IC 3DRVR/5RCVR RS232 3V 32-QFN
U17 | 1 | PCF8563T | PCF8563T/F4,118 | NXP Semiconductors | 8_SOIC_3.9MM | IC REAL TIME CLK/CALENDAR 8-SOIC
U18 | 1 | BR24L02FVM-WTR | BR24L02FVM-WTR | Rohm Semiconductor | MSOP8 _SMALLER | IC EEPROM 2KBIT 400KHZ 8MSOP
U19 | 1 | PCA9535BS | PCA9535BS,118 | NXP Semiconductors | HVQFN24_4X4MM | IC I/O EXPANDER I2C 16B 24HVQFN
U20, U21, U24 | 3 | SN74LVC1G08DCKR | SN74LVC1G08DCKR | Texas Instruments | SC70_5 | SINGLE POSITIVE AND GATE SC-70
U22 | 1 | ISL6236AIRZ | ISL6236AIRZ | Intersil | 32_VFQFN_EXPOSED_PAD | IC MAIN PWR CTRLR QUAD 32-QFN
Y1 | 1 | 12.288MHz | ASFLMB-12.288MHZ-LR-T | Abracon Corporation | ASFLMB | OSC MEMS 12.288 MHZ SMD
Y2 | 1 | 24MHz | ABM7-24.000MHZ-D-2-Y-T | Abracon Corporation | ABM7_V1_1 | CRYSTAL 24.0000MHZ 18PF SMD
Y3 | 1 | 32.768kHz | ABS06-32.768KHZ-9-1-T | Abracon Corporation | ABS06 | CRYSTAL 32.768 KHZ 9.0 PF SMD
Total de componentes com MPN | 546

Sheet: Itens_auxiliares
Itens auxiliares e itens só no esquemático
Elementos mecânicos, pontos de teste e referências complementares, separados da BOM principal.
Placa | Designator | Qtd. | Comentário | MPN | Fabricante | Classificação | Footprint
Módulo | FID1 | 1 | FID_1MM_SMALL |  |  | Fiducial | FID_40X52D
Módulo | FID2 | 1 | FID_1MM_SMALL |  |  | Fiducial | FID_40X52D
Módulo | FID3 | 1 | FID_1MM_SMALL |  |  | Fiducial | FID_40X52D
Módulo | FID4 | 1 | FID_1MM_SMALL |  |  | Fiducial | FID_40X52D
Módulo | MH1 | 1 | MH_5MMC_2.2MMD |  |  | Furo de montagem | MH_5MMD_2.2MMD
Módulo | MH2 | 1 | MH_5MMC_2.2MMD |  |  | Furo de montagem | MH_5MMD_2.2MMD
Módulo | MH3 | 1 | MH_5MMC_2.2MMD |  |  | Furo de montagem | MH_5MMD_2.2MMD
Módulo | MH4 | 1 | MH_5MMC_2.2MMD |  |  | Furo de montagem | MH_5MMD_2.2MMD
Módulo | TP3 | 1 | TP_25MILC |  |  | Ponto de teste | TP_25C
Módulo | TP5 | 1 | TP_25MILC |  |  | Ponto de teste | TP_25C
Módulo | TP6 | 1 | TP_25MILC |  |  | Ponto de teste | TP_25C
Módulo | TP7 | 1 | TP_25MILC |  |  | Ponto de teste | TP_25C
Módulo | TP8 | 1 | TP_25MILC |  |  | Ponto de teste | TP_25C
Módulo | TP9 | 1 | TP_25MILC |  |  | Ponto de teste | TP_25C
Módulo | TP10 | 1 | TP_25MILC |  |  | Ponto de teste | TP_25C
Módulo | TP11 | 1 | TP_25MILC |  |  | Ponto de teste | TP_25C
Módulo | PCB1 | 1 | iMX6 Rex V1I1 PCB |  |  | Item só no esquemático: iMX6 Rex V1I1 PCB | Sem footprint no PCB
Módulo | FIRMWARE_FOR_U10 | 1 | iMX6_REX_uBOOT 1.0 |  |  | Item só no esquemático: iMX6_REX_uBOOT 1.0 | Sem footprint no PCB
Placa base | CR1 | 1 | PCIe Mini Card |  |  | Cartão de expansão representado | MINI_PCIE_FULL CARD
Placa base | CR2 | 1 | PCIe Mini Card |  |  | Cartão de expansão representado | MINI_PCIE_FULL CARD
Placa base | FID1 | 1 | FID_1MMC |  |  | Fiducial | FID_40X120D
Placa base | FID2 | 1 | FID_1MMC |  |  | Fiducial | FID_40X120D
Placa base | FID3 | 1 | FID_1MMC |  |  | Fiducial | FID_40X120D
Placa base | FID4 | 1 | FID_1MMC |  |  | Fiducial | FID_40X120D
Placa base | FID5 | 1 | FID_1MMC |  |  | Fiducial | FID_40X120D
Placa base | FID6 | 1 | FID_1MMC |  |  | Fiducial | FID_40X120D
Placa base | FID7 | 1 | FID_1MMC |  |  | Fiducial | FID_40X120D
Placa base | FID8 | 1 | FID_1MMC |  |  | Fiducial | FID_40X120D
Placa base | M1 | 1 | iMX6 Rex Module V1I1 3D |  |  | Modelo 3D | IMX6 REX MODULE 3D
Placa base | MH1 | 1 | MH_5MMC_2.2MMD |  |  | Furo de montagem | MH_5MMD_2.2MMD
Placa base | MH2 | 1 | MH_5MMC_2.2MMD |  |  | Furo de montagem | MH_5MMD_2.2MMD
Placa base | MH3 | 1 | MH_5MMC_2.2MMD |  |  | Furo de montagem | MH_5MMD_2.2MMD
Placa base | MH4 | 1 | MH_5MMC_2.2MMD |  |  | Furo de montagem | MH_5MMD_2.2MMD
Placa base | MH5 | 1 | MH_7.4MMC_3.2MMD |  |  | Furo de montagem | MH_7.4MMD_3.2MMD
Placa base | MH6 | 1 | MH_7.4MMC_3.2MMD |  |  | Furo de montagem | MH_7.4MMD_3.2MMD
Placa base | MH7 | 1 | MH_7.4MMC_3.2MMD |  |  | Furo de montagem | MH_7.4MMD_3.2MMD
Placa base | MH8 | 1 | MH_7.4MMC_3.2MMD |  |  | Furo de montagem | MH_7.4MMD_3.2MMD
Placa base | MH9 | 1 | MH_5.2MMC_2.7MMD |  |  | Furo de montagem | MH_5.2MMD_2.7MMD
Placa base | MH10 | 1 | MH_5.2MMC_2.7MMD |  |  | Furo de montagem | MH_5.2MMD_2.7MMD
Placa base | MH11 | 1 | MH_5.2MMC_2.7MMD |  |  | Furo de montagem | MH_5.2MMD_2.7MMD
Placa base | MH12 | 1 | MH_5.2MMC_2.7MMD |  |  | Furo de montagem | MH_5.2MMD_2.7MMD
Placa base | MH13 | 1 | MH_5MMC_2.2MMD |  |  | Furo de montagem | MH_5MMD_2.2MMD
Placa base | TP1 | 1 | TP_25MILC |  |  | Ponto de teste | TP_25C
Placa base | TP2 | 1 | TP_25MILC |  |  | Ponto de teste | TP_25C
Placa base | TP3 | 1 | TP_25MILC |  |  | Ponto de teste | TP_25C
Placa base | TP4 | 1 | TP_25MILC |  |  | Ponto de teste | TP_25C
Placa base | TP5 | 1 | TP_25MILC |  |  | Ponto de teste | TP_25C
Placa base | TP6 | 1 | TP_25MILC |  |  | Ponto de teste | TP_25C
Placa base | TP7 | 1 | TP_25MILC |  |  | Ponto de teste | TP_25C
Placa base | TP8 | 1 | TP_25MILC |  |  | Ponto de teste | TP_25C
Placa base | TP9 | 1 | TP_25MILC |  |  | Ponto de teste | TP_25C
Placa base | TP10 | 1 | TP_25MILC |  |  | Ponto de teste | TP_25C
Placa base | LINK2 | 1 | LINK | QPC02SXGN-RC | Sullins Connector Solutions | Item só no esquemático: CONN JUMPER SHORTING .100" GOLD | Sem footprint no PCB
Placa base | LINK1 | 1 | LINK | QPC02SXGN-RC | Sullins Connector Solutions | Item só no esquemático: CONN JUMPER SHORTING .100" GOLD | Sem footprint no PCB
Placa base | LINK3 | 1 | LINK | QPC02SXGN-RC | Sullins Connector Solutions | Item só no esquemático: CONN JUMPER SHORTING .100" GOLD | Sem footprint no PCB
Placa base | LINK5 | 1 | LINK | QPC02SXGN-RC | Sullins Connector Solutions | Item só no esquemático: CONN JUMPER SHORTING .100" GOLD | Sem footprint no PCB
Placa base | BAT1 | 1 | CR2032 | CR2032 | Panasonic - BSG | Item só no esquemático: BATTERY LITHIUM COIN 3V 20MM | Sem footprint no PCB
Placa base | LINK4 | 1 | LINK | QPC02SXGN-RC | Sullins Connector Solutions | Item só no esquemático: CONN JUMPER SHORTING .100" GOLD | Sem footprint no PCB
Placa base | PCB1 | 1 | iMX6 Rex Baseboard V1I1 PCB |  |  | Item só no esquemático: iMX6 Rex Baseboard V1I1 PCB | Sem footprint no PCB

Sheet: Cotacao
JLCPCB — Orçamento de fabricação e montagem
Valores em dólares americanos (USD)
Item | Quantidade | Valor do item (USD) | Prazo de produção | Configuração
Módulo iMX6 Rex — PCB | 5 | US$510.03 | 14–15 dias | ENIG; verde; 1,6 mm
Placa base — PCB | 5 | US$43.50 | 8–9 dias | OSP; verde; 1,6 mm
Placa base — PCBA | 2 | US$330.53 | 5–6 dias | Montagem dos dois lados
Subtotal dos itens, sem frete e tributos |  | US$884.06
Frete do módulo |  | US$42.51 | 4–8 dias úteis | DHL Express • 0,15 kg
Subtotal de fabricação e montagem: frete e tributos separados.
Placa base: fabricação de 5 PCBs e montagem de 2 unidades, nos dois lados.
Módulo HDI: serviço de montagem PCBA indisponível nesta cotação.
Referências: Cotacao/01_Cotacao_modulo_HDI.png e 02_Carrinho_PCB_e_montagem.png.
