CarloRenan/PCB_Avancado_iMX6_Rex/(list of files, drawings)

Other design files:
PCB_Avancado/Projetos/Modulo_L7-02/[01] - COVER PAGE.SchDoc
PCB_Avancado/Projetos/Modulo_L7-02/[02] - BLOCK DIAGRAM.SchDoc
PCB_Avancado/Projetos/Modulo_L7-02/[03] - CONNECTORS.SchDoc
PCB_Avancado/Projetos/Modulo_L7-02/[04] - CPU - DDR3, DDR3 MEM.SchDoc
PCB_Avancado/Projetos/Modulo_L7-02/[05] - CPU - PCIE, SATA.SchDoc
PCB_Avancado/Projetos/Modulo_L7-02/[06] - CPU - HDMI, LVDS.SchDoc
PCB_Avancado/Projetos/Modulo_L7-02/[07] - CPU - USB, ETHERNET.SchDoc
PCB_Avancado/Projetos/Modulo_L7-02/[08] - CPU - SPI, I2C, SD, MMC.SchDoc
PCB_Avancado/Projetos/Modulo_L7-02/[09] - CPU - UART, AUDIO.SchDoc
PCB_Avancado/Projetos/Modulo_L7-02/[10] - CPU - JTAG, CONTROL.SchDoc
PCB_Avancado/Projetos/Modulo_L7-02/[11] - CPU - POWER.SchDoc
PCB_Avancado/Projetos/Modulo_L7-02/[12] - CPU - UNUSED.SchDoc
PCB_Avancado/Projetos/Modulo_L7-02/[13] - ETHERNET PHY.SchDoc
PCB_Avancado/Projetos/Modulo_L7-02/[14] - SPI FLASH, LEDS.SchDoc
PCB_Avancado/Projetos/Modulo_L7-02/[15] - PWR 3V3, 1V375.SchDoc
PCB_Avancado/Projetos/Modulo_L7-02/[16] - PWR 2V5, 1V5.SchDoc
PCB_Avancado/Projetos/Modulo_L7-02/[17] - MECH.SchDoc
PCB_Avancado/Projetos/Modulo_L7-02/[18] - POWER SEQUENCING.SchDoc
PCB_Avancado/Projetos/Modulo_L7-02/[19] - DOC REVISION HISTORY.SchDoc
PCB_Avancado/Projetos/Modulo_L7-02/iMX6 Rex_V1I1 Project.SchDoc
PCB_Avancado/Projetos/Modulo_L7-02/iMX6 Rex_V1I1.PrjPcb
PCB_Avancado/Projetos/Modulo_L7-02/iMX6 Rex_V1I1_PCB.PcbDoc
PCB_Avancado/Projetos/Placa_base_L7-01/[01] - COVER PAGE.SchDoc
PCB_Avancado/Projetos/Placa_base_L7-01/[02] - BLOCK DIAGRAM.SchDoc
PCB_Avancado/Projetos/Placa_base_L7-01/[03] - CONNECTORS.SchDoc
PCB_Avancado/Projetos/Placa_base_L7-01/[04] - PCIE MINI 1, PCIE.SchDoc
PCB_Avancado/Projetos/Placa_base_L7-01/[05] - PCIE MINI 2, AUDIO2.SchDoc
PCB_Avancado/Projetos/Placa_base_L7-01/[06] - SATA, CFAST.SchDoc
PCB_Avancado/Projetos/Placa_base_L7-01/[07] - HDMI.SchDoc
PCB_Avancado/Projetos/Placa_base_L7-01/[08] - LVDS.SchDoc
PCB_Avancado/Projetos/Placa_base_L7-01/[09] - USB.SchDoc
PCB_Avancado/Projetos/Placa_base_L7-01/[10] - ETHERNET.SchDoc
PCB_Avancado/Projetos/Placa_base_L7-01/[11] - AUDIO1.SchDoc
PCB_Avancado/Projetos/Placa_base_L7-01/[12] - SD.SchDoc
PCB_Avancado/Projetos/Placa_base_L7-01/[13] - UARTS.SchDoc
PCB_Avancado/Projetos/Placa_base_L7-01/[14] - RTC, EEPROM, GPIO, TOUCH SCREEN.SchDoc
PCB_Avancado/Projetos/Placa_base_L7-01/[15] - MISC, JTAG, HEADERS.SchDoc
PCB_Avancado/Projetos/Placa_base_L7-01/[16] - POWERS 5V, 3V3.SchDoc
PCB_Avancado/Projetos/Placa_base_L7-01/[17] - PWR IN, LEDS, BUTTONS, MECH.SchDoc
PCB_Avancado/Projetos/Placa_base_L7-01/[18] - DOC, POWER SEQUENCING.SchDoc
PCB_Avancado/Projetos/Placa_base_L7-01/[19] - REVISION HISTORY.SchDoc
PCB_Avancado/Projetos/Placa_base_L7-01/iMX6 Rex Development Baseboard V1I1 Project.SchDoc
PCB_Avancado/Projetos/Placa_base_L7-01/iMX6 Rex Development Baseboard V1I1.PrjPcb
PCB_Avancado/Projetos/Placa_base_L7-01/iMX6 Rex Development Baseboard V1I1_PCB.PcbDoc
