CarloRenan/PCB_Avancado_iMX6_Rex/(commit log)

2026-10-13 Organiza documentação do curso, BOM e cotação JLCPCB
2026-10-13 Adiciona arquivos Altium originais do módulo — etapa L7-02
2026-10-14 Adiciona arquivos Altium originais da placa base — etapa L7-01
2026-10-14 Adiciona explicação do circuito, galeria 3D e planilha da entrega
